Spal13/spal13.github.io/README.md

# ME405 Final Project Report
This repository presents our final hardware and software for enabling a Romi robot to autonomously complete an obstacle course. This obstacle course required line following, bump sensing, and location estimation, all achieved through integrated sensor data and control algorithms. Additionally, we developed a real-time user interface which wirelessly displayed Romi's location and associated data. This document summarizes our system design and implementation.

The full repository can be found [here](https://github.com/Spal13/spal13.github.io).

A video of this project in action can be found [here](https://drive.google.com/file/d/19B1MOBspGuQugUwJ9CemePyic-vluhUs/view?usp=sharing).

## Hardware
### Romi
The Pololu Romi robot is the main hardware used in this project. Romi is a differential drive robot with two wheels powered by DC motors. It uses 70 mm diameter wheels and has a chassis diameter of 165 mm. Romi utilized a power distribution & motor driver combination PCB. The DC motors were integrated with quadrature encoders and operated via PWM. Romi operated off of rechargeable AA batteries in a 6S configuration (6 AA batteries in series), outputting approximately 7.2V nominally. 

### Sensors
#### Encoders
The Romi uses two quadrature incremental encoders attached to the motors to measure wheel rotation. These encoders generate two digital signals that are offset in phase, allowing both the amount of rotation and the direction of motion to be determined. In this project, the STM32 timer hardware was used in encoder mode to read the pulses efficiently. The encoder counts were then used to track wheel position, and the change in counts over time was used to calculate wheel velocity.
#### Line Sensor
The line sensor used was a QTRX-MD-13A analog IR reflectance sensor array with 13 sensors spaced at 8 mm pitch, though only the center 9 sensors were used in this project. The board was powered from the 3.3V rail on the STM32 NUCLEO board. Each sensor on this array output analog voltages based on surface reflectivity. These analog readings were calibrated and used to generate a centroid value, which provided an estimate of the line position for line following.

<p align="center">
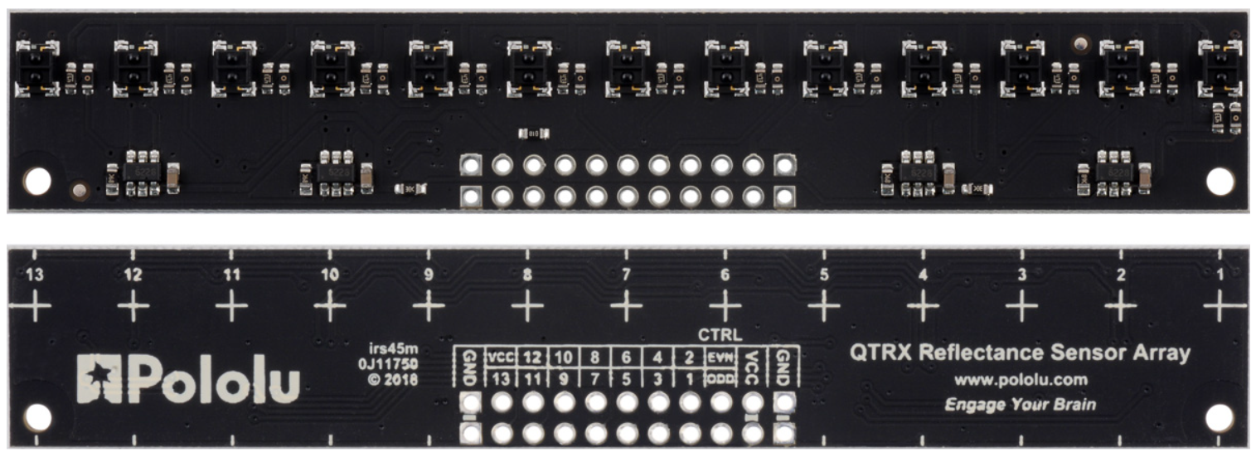
[picture p1: Media/IR_SENSOR.png]
  <br>
  <em>Line Sensor (QTRX-MD-13A)</em>
</p>

#### IMU
The system uses a BNO055 inertial measurement unit, which integrates a 3-axis accelerometer, gyroscope, and magnetometer. The sensor operates over I2C and performs onboard sensor fusion to provide orientation data directly as Euler angles (roll, pitch, and yaw). The IMU also provides angular velocity measurements from the gyroscope. The main data captured from the IMU was the YAW of the Romi for navigation control without using the line sensor. 

<p align="center">
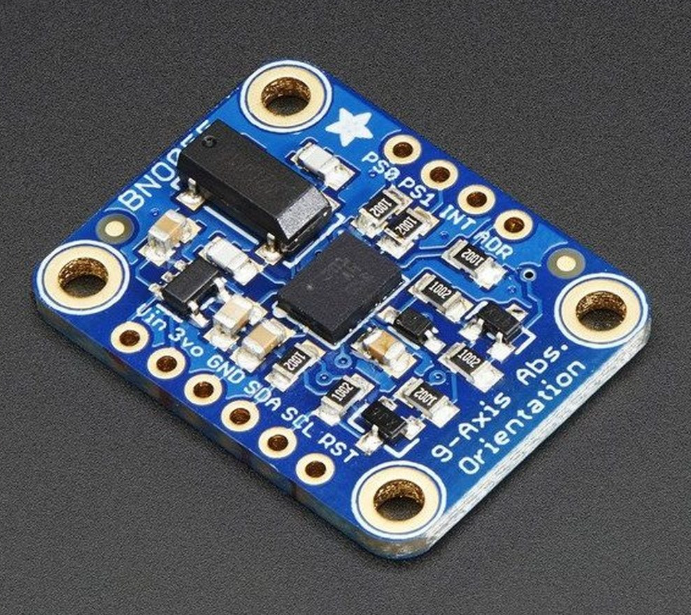
[picture p2: Media/IMU_SENSOR.png]
  <br>
  <em>BNO055 IMU Sensor</em>
</p>

#### Bump Sensors
The system uses snap-action SPDT mechanical switches as bump sensors to detect collisions with obstacles. Each switch is connected with an external pull up resistor that we integrated into the cable/harness of each bump sensor, creating an active low digital input to the microcontroller. Two sensors (left and right) were placed in the front of Romi and was used to detect which side of the robot encountered an obstacle. When the switch is pressed, the input is pulled low, indicating the Romi has bumped into an obstacle. 

<p align="center">
  <br>
  <em>Bump Sensors (Left and Right)</em>
</p>

#### Battery Sensing
We included sensing of the battery voltage to display the SOC of our batteries as well as generate a scaler value that we could apply to our motor gains as the batteries discharged. The gain scaler was never implemented.
Because the battery voltage was larger than the maximum input voltage of 3.3V, a voltage divider was used to scale down the voltage from a maximum voltage of approximately 9V to approximately 2.93V.

### Control System
#### STM32 & Shoe of Brian
The system is controlled using an STM32 Nucleo-L476RG microcontroller running MicroPython. The Nucleo interfaces with all sensors and actuators (motors) and executes the main control logic. 

A Shoe of Brian board was used as an interface when working with MicroPython, allowing us to upload micropython program files such as main scripts, drivers, and task files.
### Communication System
#### Communication Module (ESP32)
Two ESP32 modules were used to implement a transparent serial bridge between the STM32 and a laptop. The ESP32 on Romi relayed data between UART4 and ESP-Now (a wireless communication protocal), transmitting received serial data wirelessly and forwarding incoming wireless data to the STM32. The second ESP32, connected via USB, performed a similar role, bridging wireless communication to the laptop over USB.

### Custom 3D Prints
Custom hardware was 3D printed to allow for the bump sensors to be placed in front of Romi without interfering with the line sensor. The custom mount was also given a "C" shape to be able to securely move solo cups around the obstacle course for bonus points. Unfortunately, this feature was never utilized as we did not attempt to move any cups.

### NUCELO Pinout
Below, a table is shown documenting our final pinout of the NUCLEO board to all of the Romi sensors and motors, including power distribution and I/O

| Pin | Function | Description | Cable |
|-----|---|---|---|
| **NUCLEO Power IN** ||||
| Vin | Vin Power IN | VSW (battery voltage after switch), VSW_nom = 8.4V | Nucleo Power Cable [Red] |
| GND | GND | Connected to Power Distribution Board GND | Nucleo Power Cable [Black] |
| **RIGHT Motor Control** ||||
| PA_0 | PWM2/1 Input | RIGHT motor encoder CH.A | Encoder Cable [Blue] |
| PA_1 | PWM2/2 Input | RIGHT motor encoder CH.B | Encoder Cable [Yellow] |
| PB_5 | GPIO Output | RIGHT motor direction (0 = FWD; 1 = REV) | Motor Control Cable [Blue] |
| PB_3 | GPIO Output | RIGHT motor SLEEP (0 = Sleep; 1 = Enabled) | Motor Control Cable [Yellow] |
| PA_10 | PWM1/3 Output | RIGHT motor PWM (effort) | Motor Control Cable [Green] |
| **LEFT Motor Control** ||||
| PA_6 | PWM3/1 Input | LEFT motor encoder CH.A | Encoder Cable [Blue] |
| PA_7 | PWM3/2 Input | LEFT motor encoder CH.B | Encoder Cable [Yellow] |
| PC_7 | GPIO Output | LEFT motor direction (0 = FWD; 1 = REV) | Motor Control Cable [Blue] |
| PA_9 | GPIO Output | LEFT motor SLEEP (0 = Sleep; 1 = Enabled) | Motor Control Cable [Yellow] |
| PA_8 | PWM1/1 Output | LEFT motor PWM (effort) | Motor Control Cable [Green] |
| **IMU BNO055** ||||
| 5V | 5V Power OUT | Vin to IMU (5V nominal) | IMU Cable [Red] |
| GND | GND | GND to IMU | IMU Cable [Black] |
| PB_11 | I2C1_SDA | IMU I2C Data | IMU Cable [Yellow] |
| PB_10 | I2C1_SCL | IMU I2C Clock | IMU Cable [Blue] |
| PC_10 | GPIO Output | IMU Reset (0 = RST; 1 = nRST) | IMU Cable [Green] |
| **Line Sensor** ||||
| 3V3 | 3V3 Power OUT | Vin to Line Sensor | Line Sensor Cable [Orange] |
| GND | GND | GND to Line Sensor | Line Sensor Cable [Brown] |
| PA_0 | AnalogIn | Reflectance Sensor Input | Line Sensor Cable [Brown] |
| PA_1 | AnalogIn | Reflectance Sensor Input | Line Sensor Cable [Brown] |
| PA_2 | AnalogIn | Reflectance Sensor Input | Line Sensor Cable [Brown] |
| PA_3 | AnalogIn | Reflectance Sensor Input | Line Sensor Cable [Brown] |
| PA_4 | AnalogIn | Reflectance Sensor Input | Line Sensor Cable [Brown] |
| PA_5 | AnalogIn | Reflectance Sensor Input | Line Sensor Cable [Brown] |
| PC_6 | AnalogIn | Reflectance Sensor Input | Line Sensor Cable [Brown] |
| PC_7 | AnalogIn | Reflectance Sensor Input | Line Sensor Cable [Brown] |
| PC_8 | AnalogIn | Reflectance Sensor Input | Line Sensor Cable [Brown] |
| **Bump Sensors (x2)** ||||
| 3V3 | 3V3 Power OUT | Pulled-up supply to bump sensors | Bump Sensor Cable [White] |
| GND | GND | GND to bump sensors | Bump Sensor Cable [Black] |
| PC_4 | GPIO Input | Left bump (Active LO) | Bump Sensor Cable [Purple] |
| PH_0 | GPIO Input | Right bump (Active LO) | Bump Sensor Cable [Orange] |
| **ESP32 (WiFi Module)** ||||
| 3V3 | 3V3 Power OUT | Vin to ESP32 | ESP32 Cable [White] |
| GND | GND | GND to ESP32 | ESP32 Cable [Grey] |
| PC_12 | Serial_TX | RX2 (ESP32) | ESP32 Cable [White] |
| PD_2 | Serial_RX | TX2 (ESP32) | ESP32 Cable [Purple] |
| **VSENSE_BAT** ||||
| PB_1 | AnalogIn | Battery voltage sense (via divider) | Custom Cable |

<p align="center">
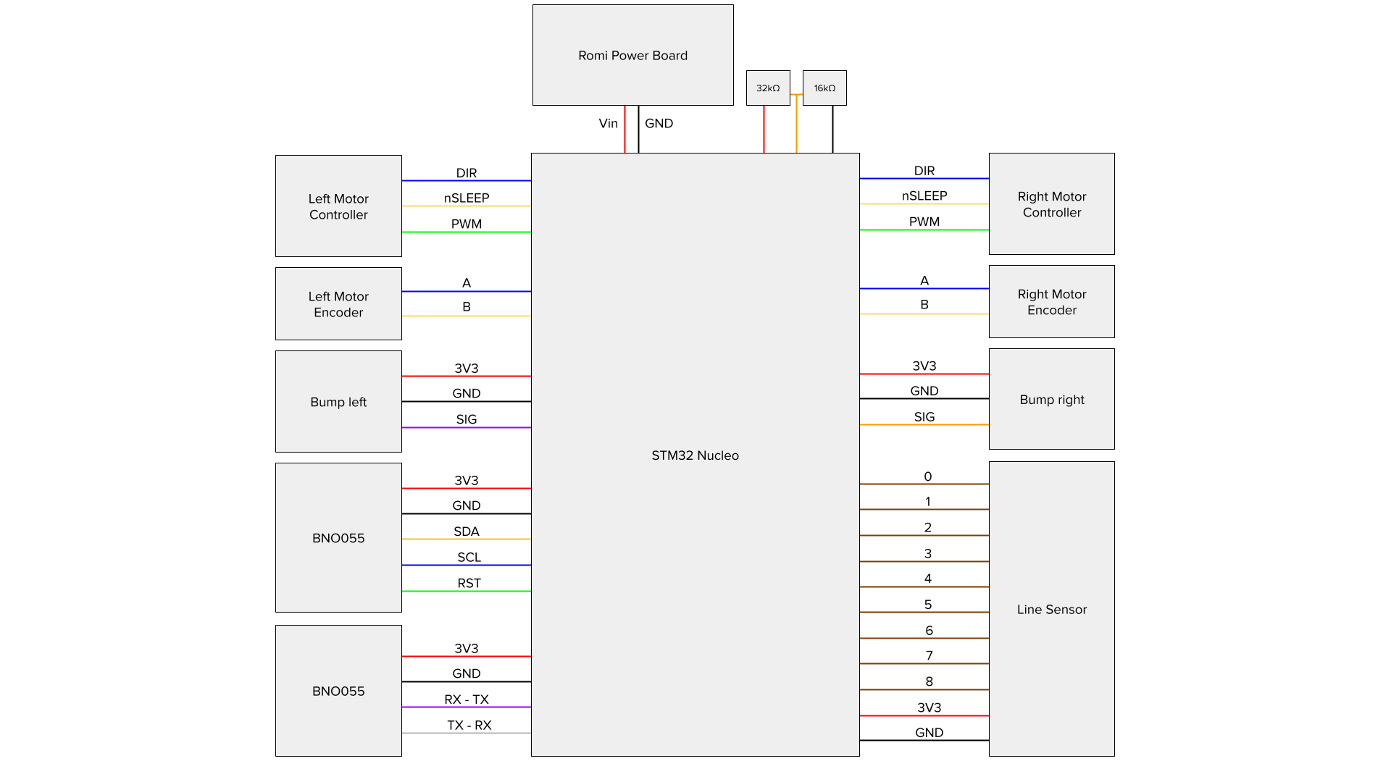
[picture p4: Media/wiring.png]
  <br>
  <em>Wiring Diagram</em>
</p>

<p align="center">
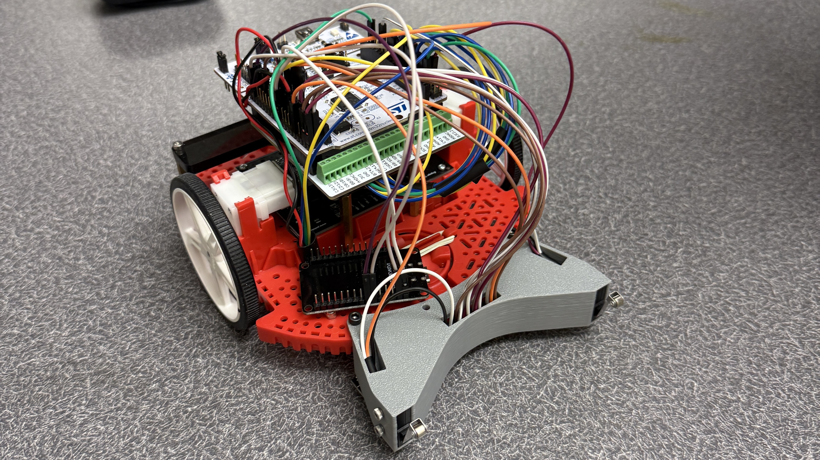
[picture p5: Media/ROMI.JPG]
  <br>
  <em>Final Romi Assembly</em>
</p>

## Software
A major focus of our software development was building robust, easy-to-use drivers so the higher-level tasks could stay simple. The goal was a “plug-and-play” system, where each driver exposed clean interfaces and handled the low-level complexity internally. This allowed our main tasks to focus on behavior rather than implementation details. In the end, only two tasks were needed: Estimator and Navigator. A task diagram is presented below.

<p align="center">
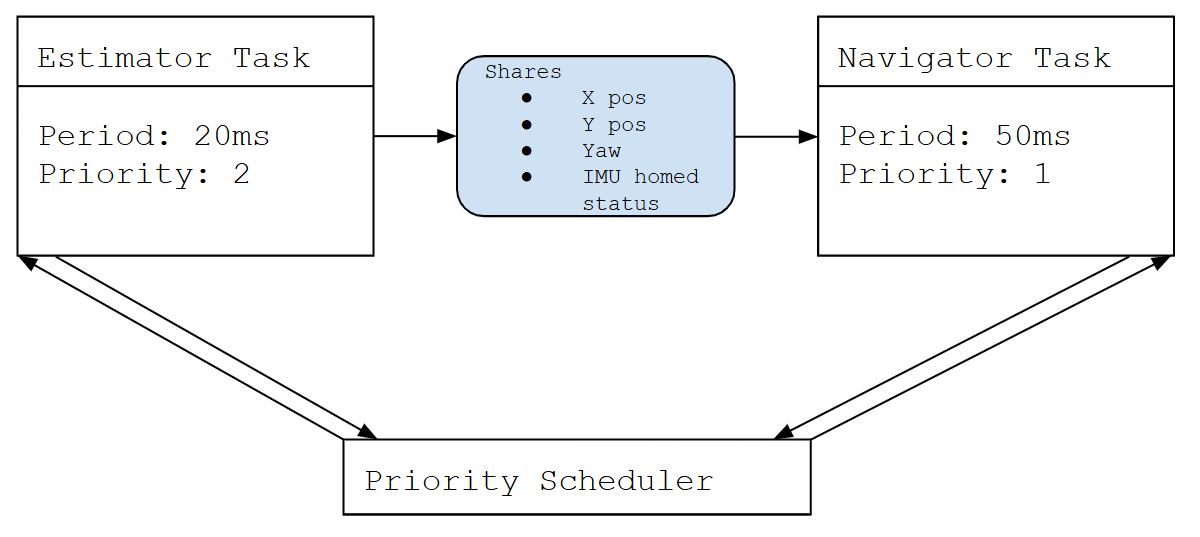
[picture p6: Media/TASK_DIAGRAM.png]
  <br>
  <em>System Task Diagram</em>
</p>

### Estimator
<p align="center">
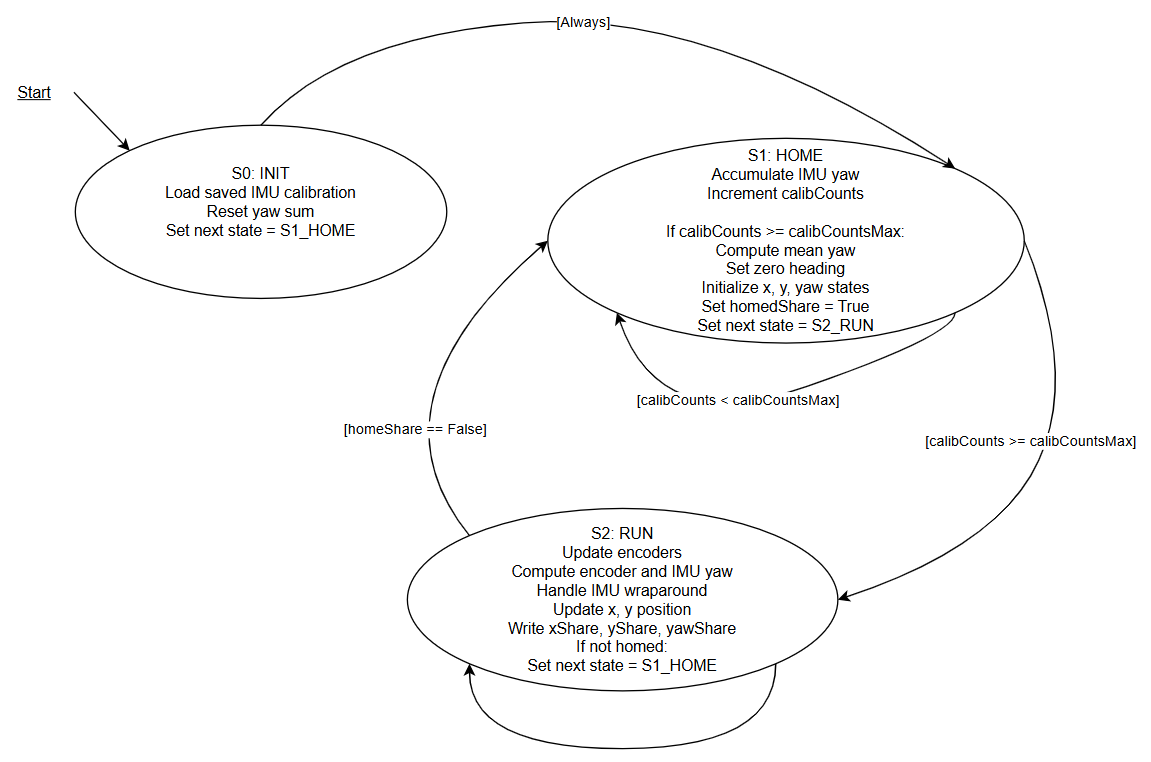
[picture p7: Media/ESTIMATOR_FSM.png]
  <br>
  <em>Estimator Task Finite State Machine</em>
</p>

Estimator is responsible for continuously tracking Romi’s position and heading using encoder data. While we initially considered incorporating the IMU, we found the encoders alone provided sufficient accuracy. Over roughly 15 full-course test runs using only line, bump, and encoder data, we achieved a maximum final position error of about 50 mm, typically staying within 25 mm.
Estimator operates in three states: initialization, homing, and running. The initialization state [S0] runs once at startup to load IMU calibration data and perform setup, then transitions to homing. The homing state [S1] resets Romi’s reference position and heading, and can be triggered from the UI by pressing “h” to quickly restart a trial without rebooting. The running state [S2] executes every 20 ms, reading encoder values to compute heading from wheel arc lengths, then using Euler integration to update global X and Y position (equations below). This state continuously shares position and heading data with Navigator through the use of xShare, yShare, and yawShare. 

$$
x_{new} = x_{current} + \cos(\psi)\ * v_{avg}\ * \Delta t
$$
$$
x_{new} = x_{current} + \sin(\psi)\ * v_{avg}\ * \Delta t
$$
$$
\psi = \frac{1}{140mm} * (s_{r}\ - s_{l}\)
$$

### Navigator
<p align="center">
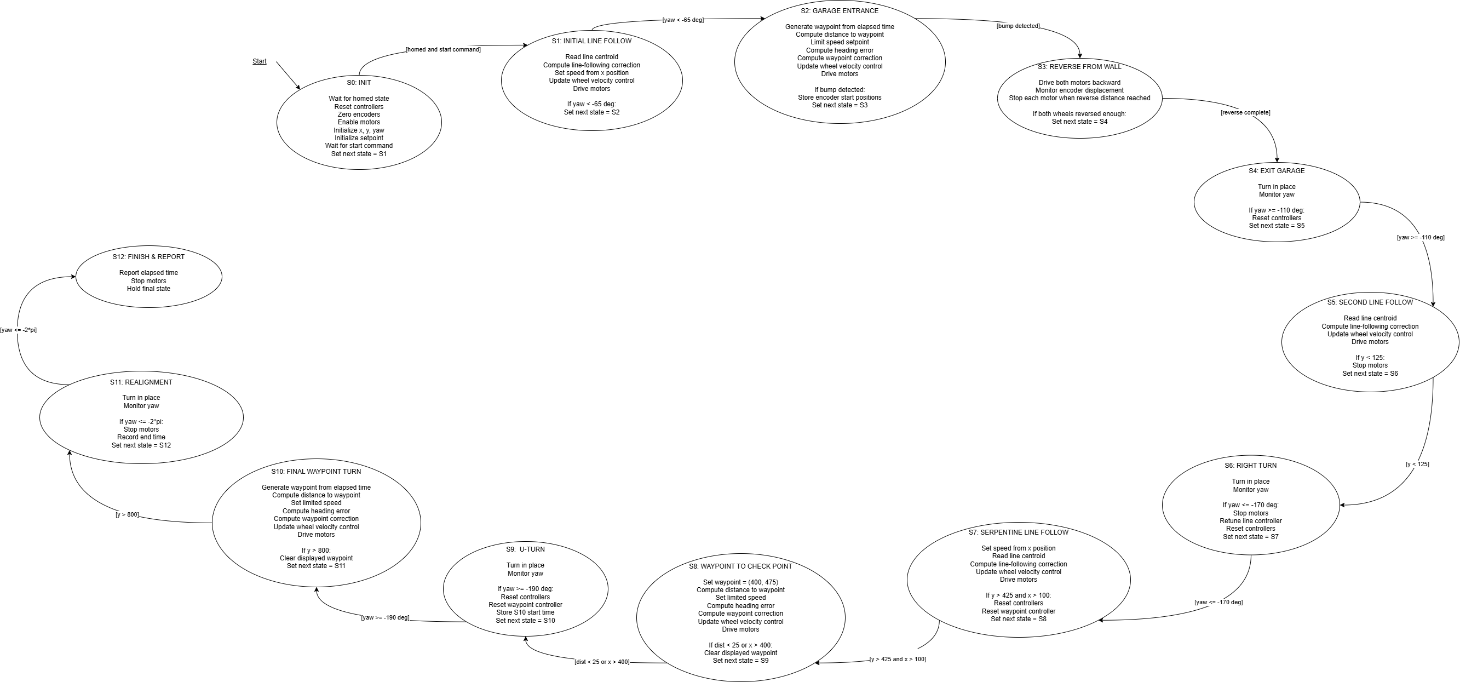
[picture p8: Media/NAVIGATOR_FSM.png]
  <br>
  <em>Navigator Task Finite State Machine</em>
</p>

The Navigator task is the meat of our codebase. It is responsible for running different code at each stage of the course. We will admit that in a perfect world we would have moved our waypoint navigation logic to its own driver in order to maximize readability and efficiency of the code, as it is a commonly reused item. It is composed of 12 states.

S0 - Initialization
This state waits until the robot has been homed and is ready to run. Once that happens, it resets the controllers, zeroes the encoders, enables the motors, initializes Romi’s starting pose. It then waits for the user to send the start command via the user interface to begin the course.

S1 - Initial line following
Here, Romi follows the line using the IR sensor centroid value and a line-following PID controller. The speed setpoint is adjusted based on X position in order to ramp up near the beginning and ramp down near the curve at the end. Since our Y position is nearly exactly 800mm throughout the entire straight segment, we keep our yShare updated with that information until we reach the turn. Once we have turned at least 65 degrees, we change to waypoint following.

S2 - Waypoints through the parking garage
In this state Romi tracks a generated constant-velocity trajectory made up of a quarter-circle followed by a straight line segment. We use the error between Romi’s current position and the desired position to set Romi’s velocity, and the error between Romi’s current heading and desired heading (a straight line from the current location to the target location) to set the differential velocity of the wheels. The greatest challenge of developing this state was working with the atan2(y,x) function to find the heading error. Once either bump sensor is triggered from the wall at the end of the parking garage, Romi moves to the next state.

S3 - Back away from the wall
After detecting contact, Romi briefly drives backward by 10mm. This creates space between the cup catcher and the obstacle before starting the next maneuver.

S4 - Turn in place
In this state, Romi rotates 70º downwards to face the new line segment. We use open-loop control to keep the code simple. Because of this we command a turn of less than 90º to account for slight overshoot. Once the turn is complete, the motor and line controllers are reset so Romi can cleanly re-enter line following mode.

S5 - Line following out of the parking garage
Romi resumes line following using the same technique as before and continues driving until it reaches Y = 125mm.

S6 - Turn to enter the slalom section
This is another in-place turn. Romi rotates until it reaches the heading needed to enter the next part of the course, then stops, and resets the control loops before continuing. We also update the line following PID driver with slightly more aggressive gains, which we found improved performance on the tight curves. 

S7 - Line following through the slalom curves
This state again reuses the typical line following code, although with more aggressive gains and a slower setpoint as compared to the straight line section. Once the estimated position indicates Romi has cleared this region, it transitions back to waypoint control.

S8 - Waypoints from CP3 to CP4
We discovered that since our estimator provided excellent position data, we could rely on that instead of line following to get from CP3 to CP4. This resulted in higher performance without the need for relying on a sensor which could malfunction. The trajectory here is composed of a large 180º turn and a straight line segment which closely follows the black line on the board. We use the same control logic as in the parking garage, but now with a slightly faster setpoint. Once we reach or overshoot CP4, we move to turning around.

S9 - Turn toward the final path
This state performs another heading adjustment in place. Once Romi spins about 180º counter-clockwise, the controllers are reset and the next timed waypoint path begins.

S10 - Final waypoint-following path
Romi follows another generated trajectory, made up of a quarter circle followed by a straight segment to start/end point. This guides Romi through the final portion of the course until its estimated y-position exceeds 800mm.

S11 - Final heading alignment
Once Romi reaches the start/end point, it performs one last turn to align to the final heading. After that, both motors are stopped, the run end time is recorded and sent over serial, and the task moves to its finished state.

S12 - Finished state
This is the final state. The motors turn off, and Romi waits for serial commands.

### Drivers

Our battery driver reads the raw voltage from the voltage divider and calculates the true battery voltage. Assuming a linear discharge curve (which certainly isn’t perfect), we can calculate the state of charge of the battery. We can also calculate how much to increase the motor controller gains in order to standardize performance across battery levels.

Our bump sensor driver reads the bump sensor pins and provides software debouncing. This driver can be polled to read these sensors.

Our control driver implements a PID controller so we can easily implement closed loop control in many different instances. Gains are set via set_kp, set_ki, and set_kd methods. The controller needs to be regularly updated via the update() function, which returns the new PID output.

Our encoder driver reads a quadrature encoder and returns its current position or velocity in mm or mm/s, respectively. Wheel diameter is hardcoded into this driver as we never expect different Romi wheel sizes to be used.

Our IMU diver contains a variety of helper functions to write and read from the various BNO055 I2C registers. The getAngle() and getAngleRate() functions return the current euler angles and euler angle rates in radians and radians per second, respectively.

Our IR sensor driver reads the IR sensors consecutively and returns the centroid of the black line. It also provides various helper functions such as calibration and uncertainty calculation. The calibration functions store white and black ranges for each sensor individually, and the uncertainty calculation can help us avoid driving away if we are unsure that a line is detected.

Our motor driver sets the effort and direction of a brushed motor. It also returns the estimated voltage applied to the motor in order to help during our state estimator lab.

Our serial driver provides an extremely simple interface to send key-value pairs over serial to the ESP32.

### User interface
<p align="center">
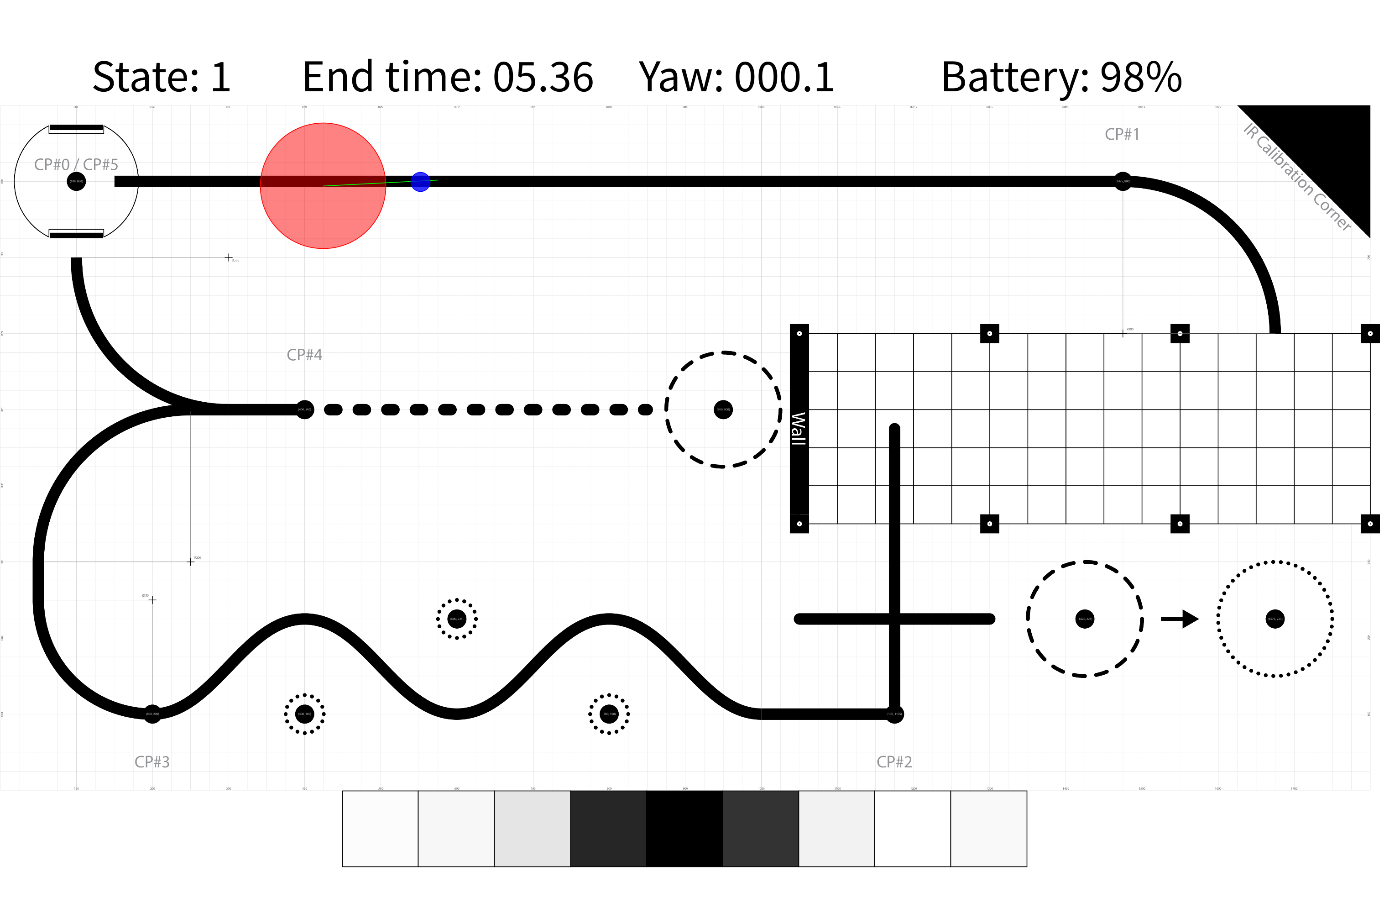
[picture p9: Media/UI.png]
  <br>
  <em>Estimator Task Finite State Machine</em>
</p>

Although not required for class, we developed a real-time wireless user interface to observe pertinent information regarding Romi and send commands using keystrokes. Processing is a language designed for creating interactive visual displays. We used it to read data from the serial input and render Romi’s live position and heading on the game board. It also displays the target position as a blue dot and current line sensor data in grayscale at the bottom. Being able to visually see what Romi sees and thinks allowed us to very quickly solve issues and visualize how different setpoints and trajectories would move it through the game board. Homing and running commands are sent via “h” and “r” keystrokes, accordingly. In the future we would love to expand this program to be a fully fledged user interface with menus for settings gains, drawing trajectories, and more.

## Conclusion
We learned a ton about software design, hardware interfaces, microcontrollers, kinematics, and teamwork through this project. If we were to continue this project we would start reorganizing the codebase to be more readable. Right now we have a lot of reused code in our navigator task which could be simplified into its own driver. We would also rely more on waypoints and trajectory generation as we are very happy with our position/heading estimator. We are very happy to see our Romi reliably and quickly completing the course and hope to use our knowledge across many future projects!
