Spal13/spal13.github.io/Media/BUMP_SENSOR.png

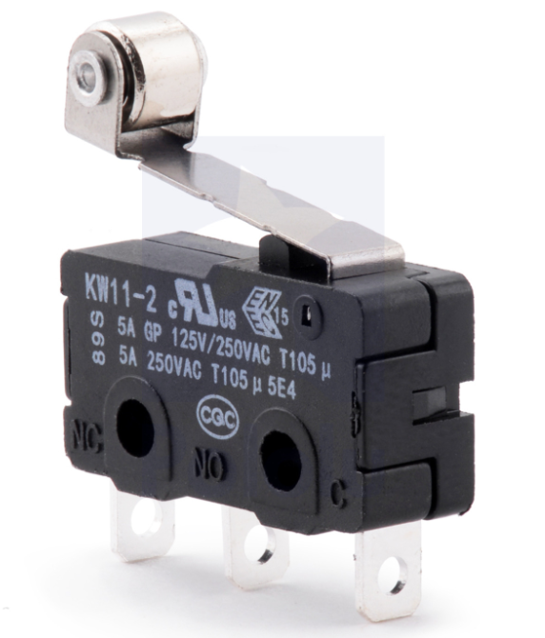
Media/BUMP_SENSOR.png
