Spal13/spal13.github.io/Physical/CupSensorMount.stl

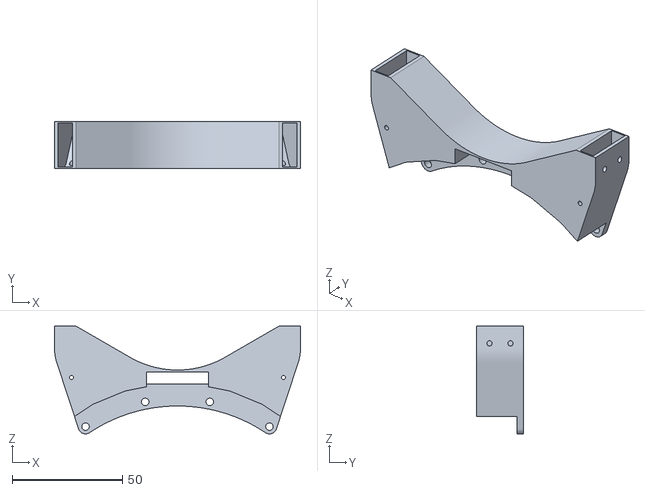
[picture p11: CAD file, 2026-03-19]
Physical/CupSensorMount.stl
111.4 x 21.2 x 48.8
