Spal13/spal13.github.io/BUMP_SENSORS.JPG

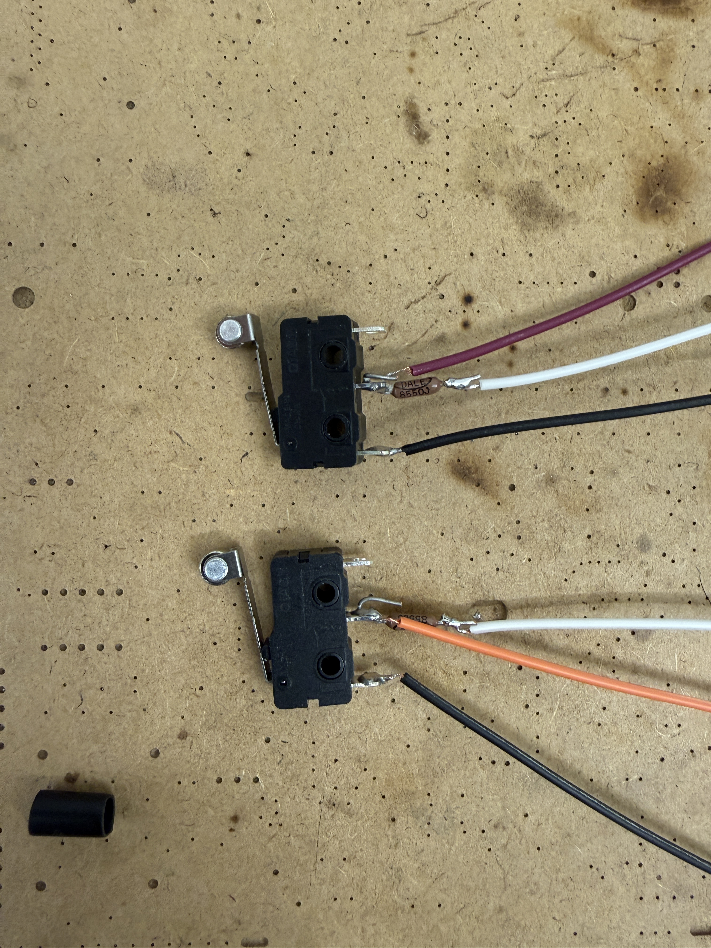
[picture p3: Media/BUMP_SENSORS.JPG]
BUMP_SENSORS.JPG
